Miapaysse/CANSAT-UltraViolet/Multimedia/PROCESS/PCB making.3.jpg

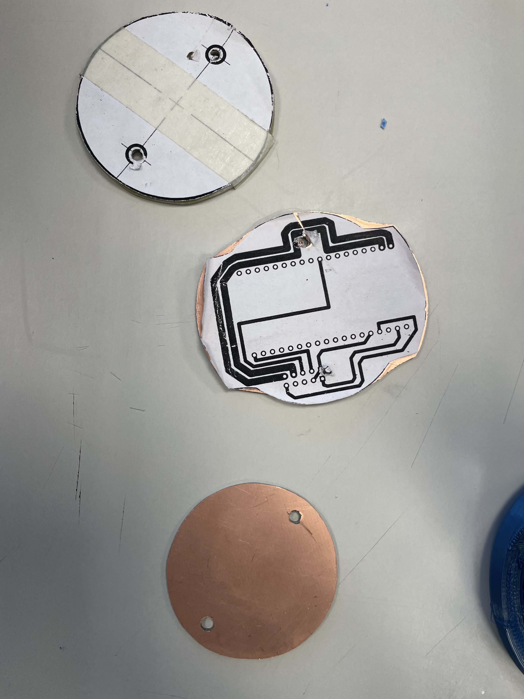
Multimedia/PROCESS/PCB making.3.jpg
