Miapaysse/CANSAT-UltraViolet/Software/Instalación.docx

# Cómo instalar Heltec ESP32 entorno de desarrollo Arduino

https://docs.heltec.org/en/node/esp32/quick_start.html

Instalar desde GitHub

https://github.com/Heltec-Aaron-Lee/WiFi_Kit_series/blob/master/InstallGuide/README_English.md
