Miapaysse/CANSAT-UltraViolet/Investigation/Links.docx

Radiación UV en Bs As

https://www.tutiempo.net/radiacion-solar/buenos-aires.html

DEM (dosis eritematosa mínima) según fototipo

https://www.sciencedirect.com/science/article/pii/S0001731020300843

Relación Índice UV - DEM

http://www.ideam.gov.co/web/tiempo-y-clima/indice-ultravioleta-iuv-

Funcionamiento del ML8511 (sensor UV)

https://learn.sparkfun.com/tutorials/ml8511-uv-sensor-hookup-guide/all
