Miapaysse/CANSAT-UltraViolet/Design/1.JPG

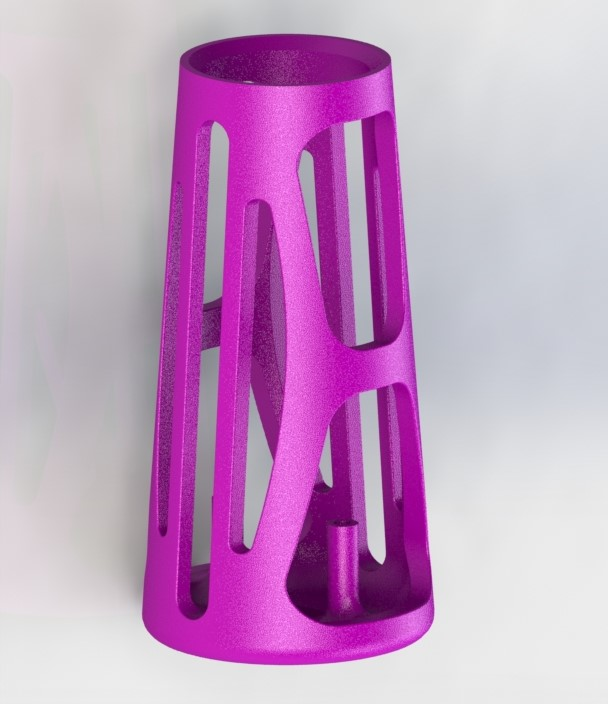
Design/1.JPG
