Miapaysse/CANSAT-UltraViolet/Design/2.JPG

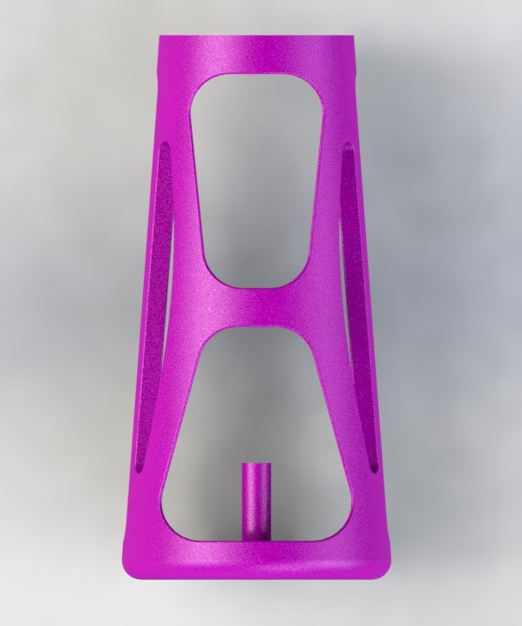
Design/2.JPG
