Miapaysse/CANSAT-UltraViolet/Design/3.JPG

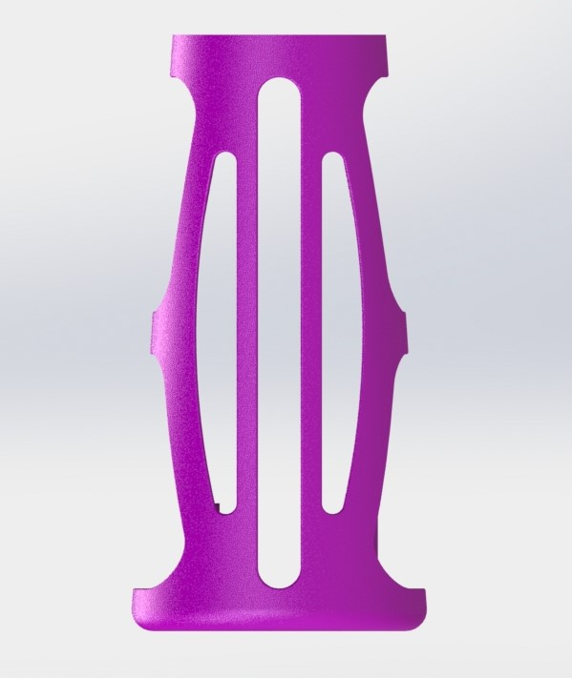
Design/3.JPG
