Miapaysse/CANSAT-UltraViolet/Design/4.JPG

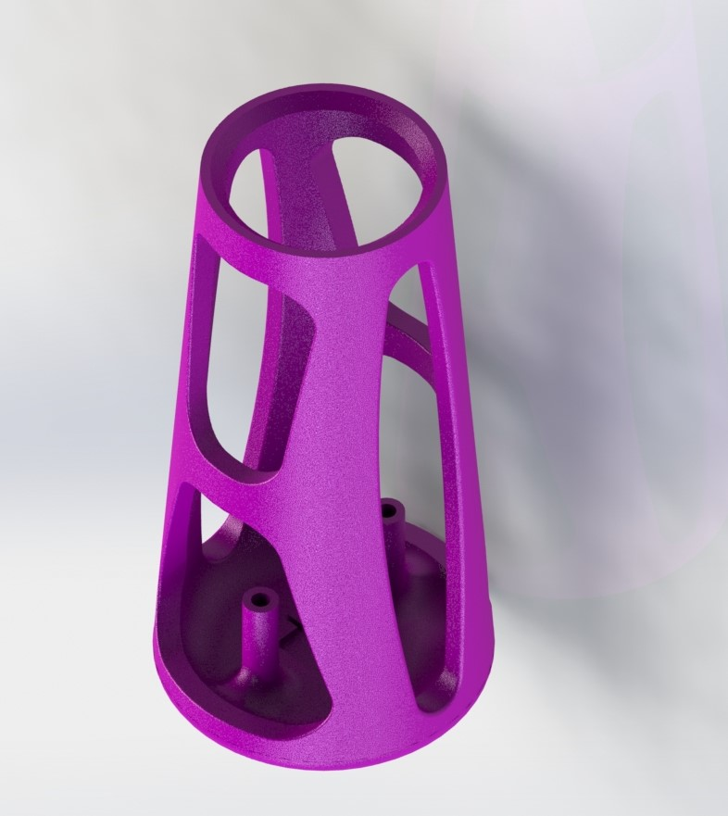
Design/4.JPG
