Miapaysse/CANSAT-UltraViolet/Design/5.JPG

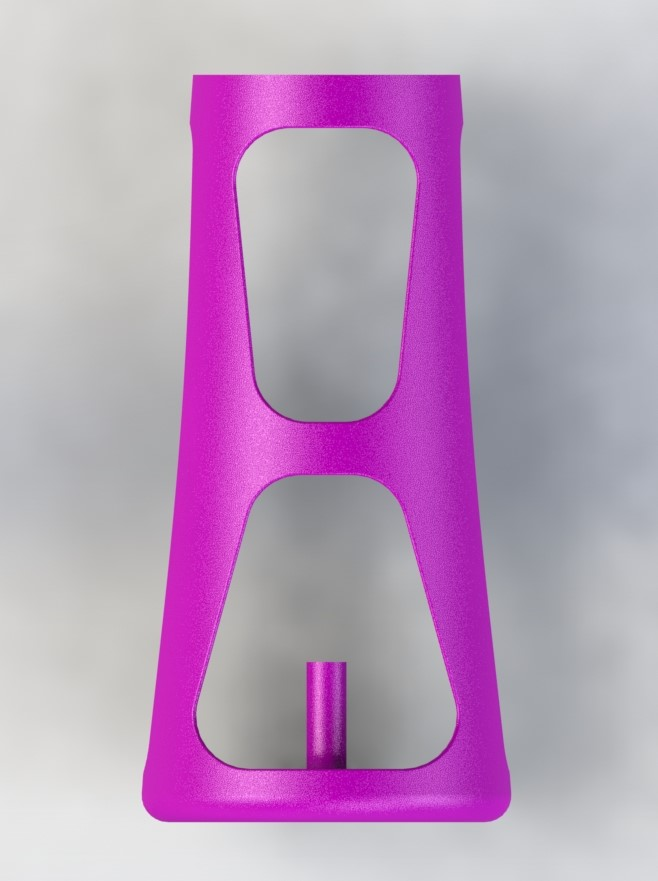
Design/5.JPG
