Miapaysse/CANSAT-UltraViolet/Design/6.JPG

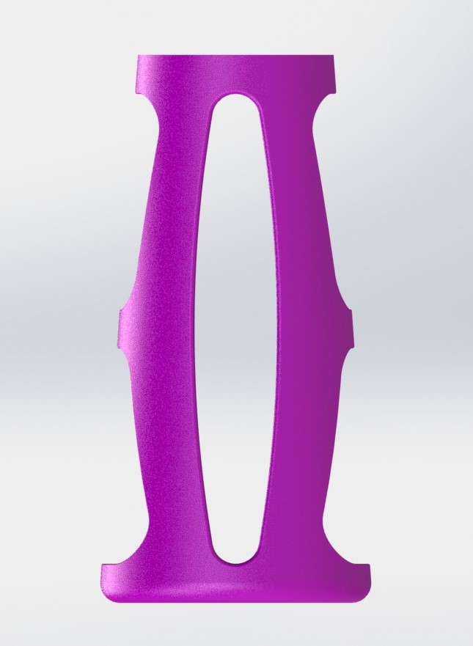
Design/6.JPG
