Miapaysse/CANSAT-UltraViolet/Multimedia/LAUNCH DAY/competitors - launch day (2).jpg

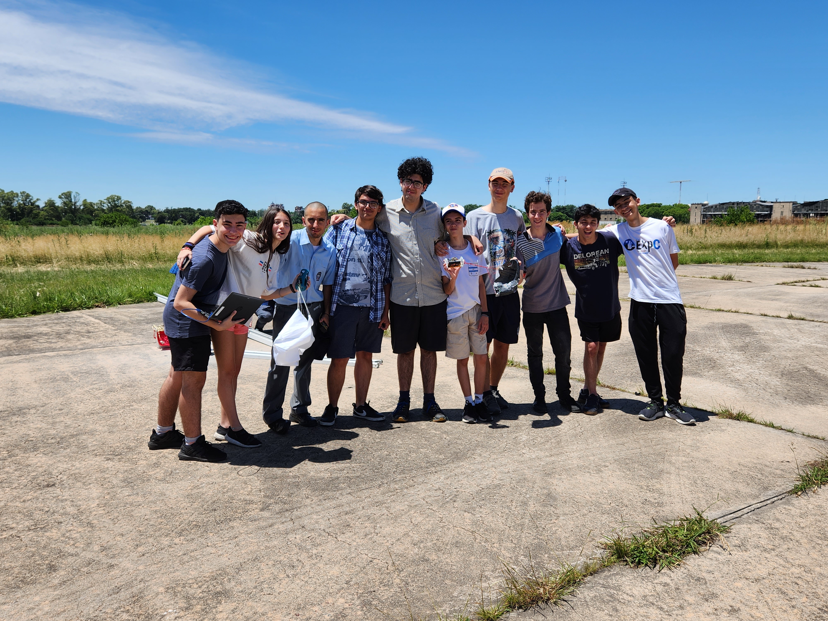
Multimedia/LAUNCH DAY/competitors - launch day (2).jpg
