Miapaysse/CANSAT-UltraViolet/Multimedia/LAUNCH DAY/Competitors - launch day.jpg

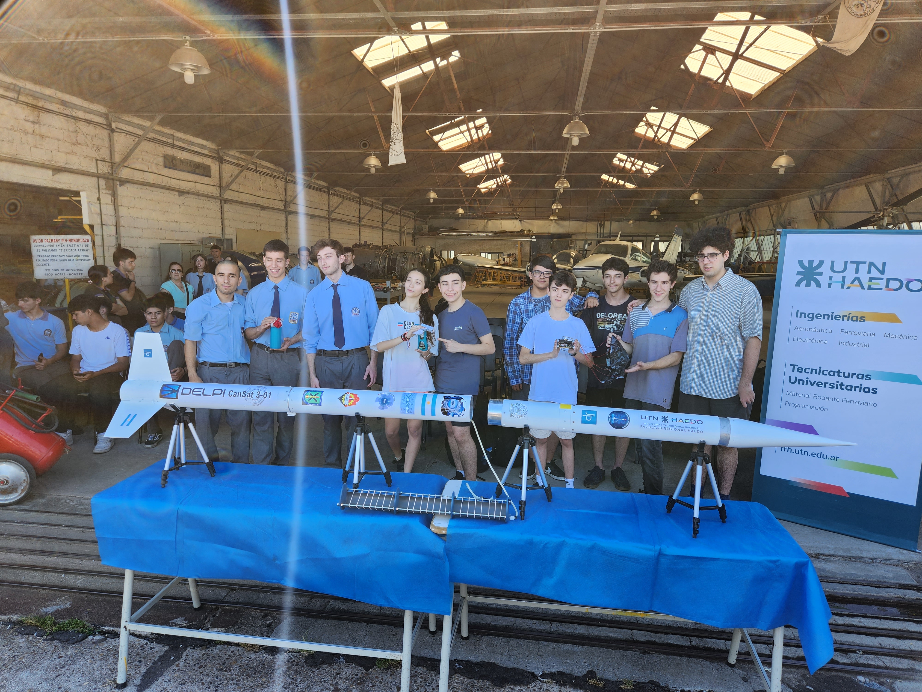
Multimedia/LAUNCH DAY/Competitors - launch day.jpg
