Miapaysse/CANSAT-UltraViolet/Multimedia/LAUNCH DAY/Expulsion (2).jpg

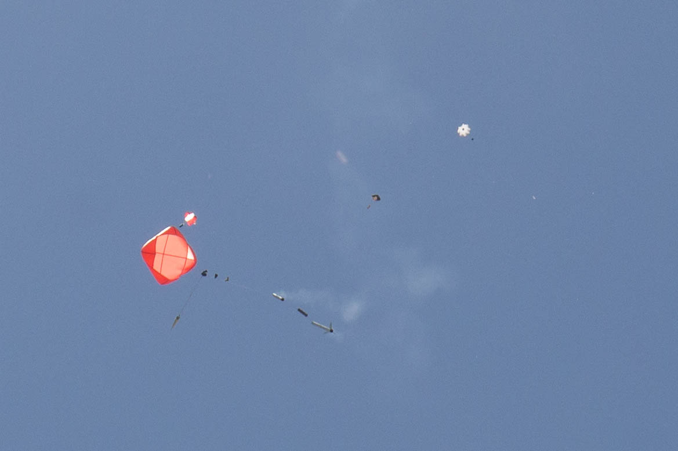
Multimedia/LAUNCH DAY/Expulsion (2).jpg
