Miapaysse/CANSAT-UltraViolet/Multimedia/LAUNCH DAY/Expulsion (3).jpg

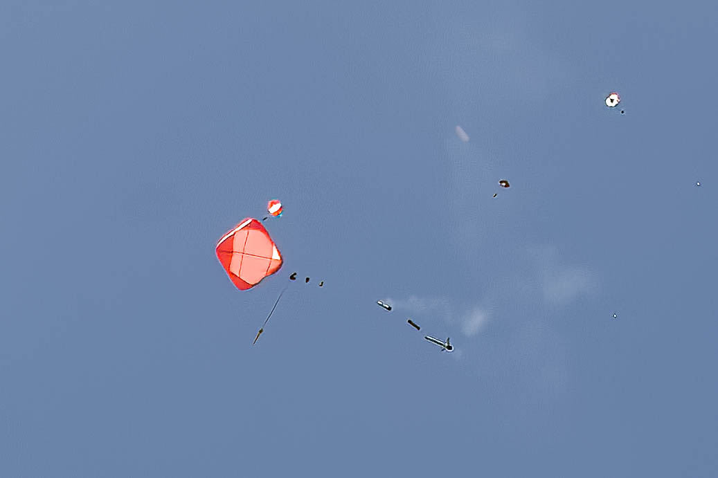
Multimedia/LAUNCH DAY/Expulsion (3).jpg
