Miapaysse/CANSAT-UltraViolet/Multimedia/LAUNCH DAY/Expulsion.jpg

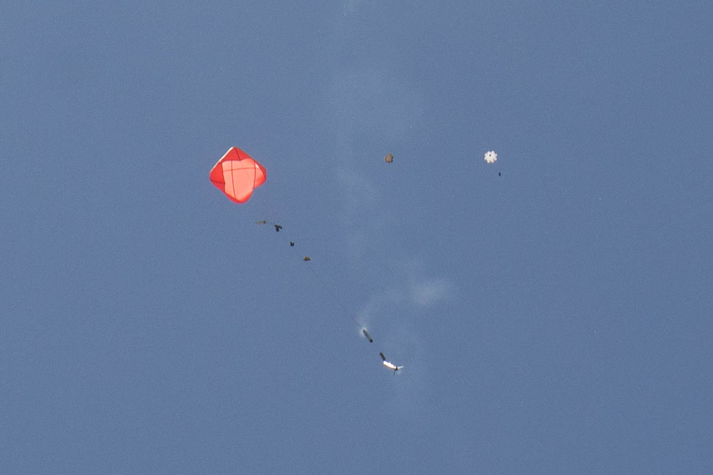
Multimedia/LAUNCH DAY/Expulsion.jpg
