Miapaysse/CANSAT-UltraViolet/Multimedia/LAUNCH DAY/Flying can-sat.jpg

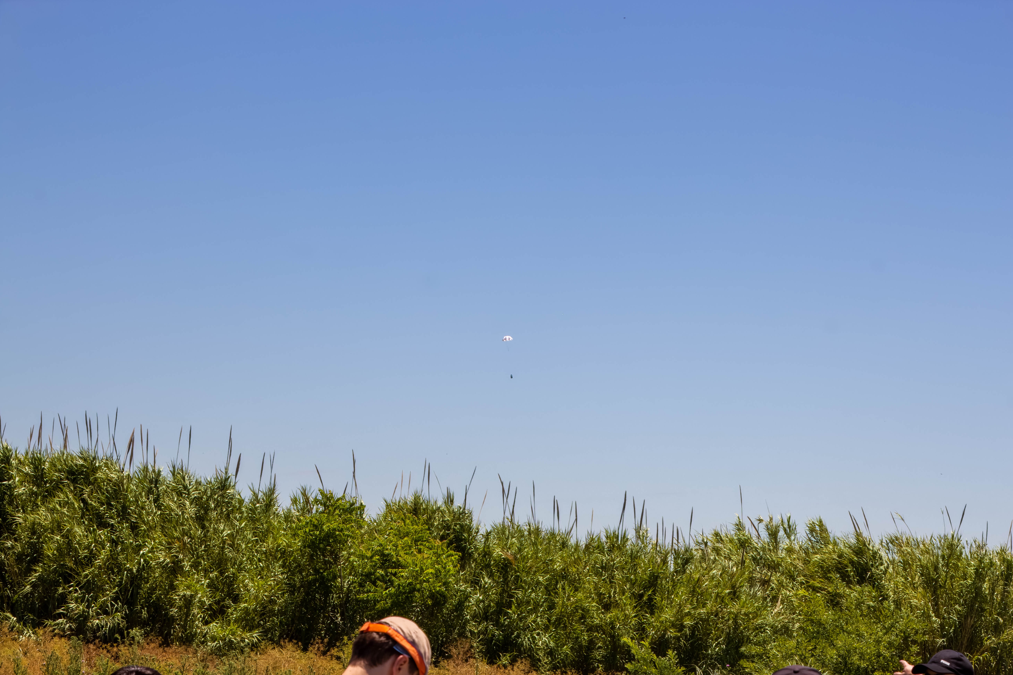
Multimedia/LAUNCH DAY/Flying can-sat.jpg
