Miapaysse/CANSAT-UltraViolet/Multimedia/LAUNCH DAY/Parachute deployment picture.JPEG

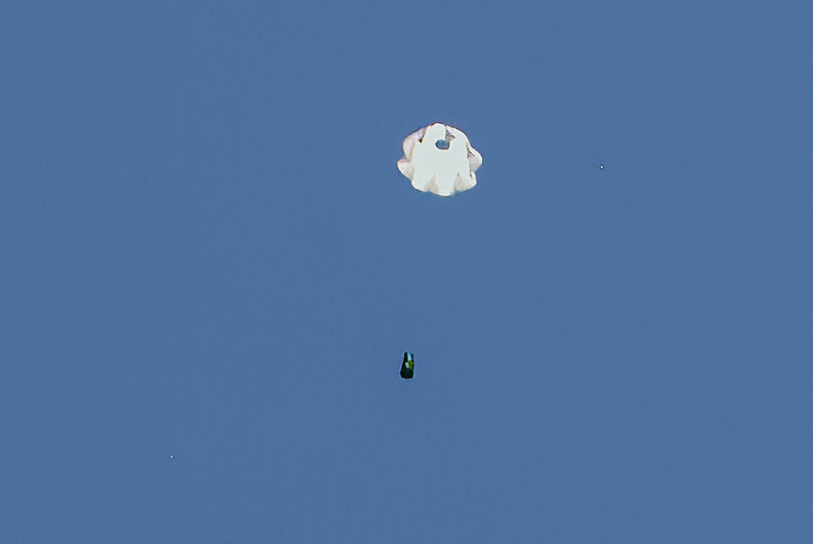
Multimedia/LAUNCH DAY/Parachute deployment picture.JPEG
