Miapaysse/CANSAT-UltraViolet/Multimedia/LAUNCH DAY/rocket (2).jpg

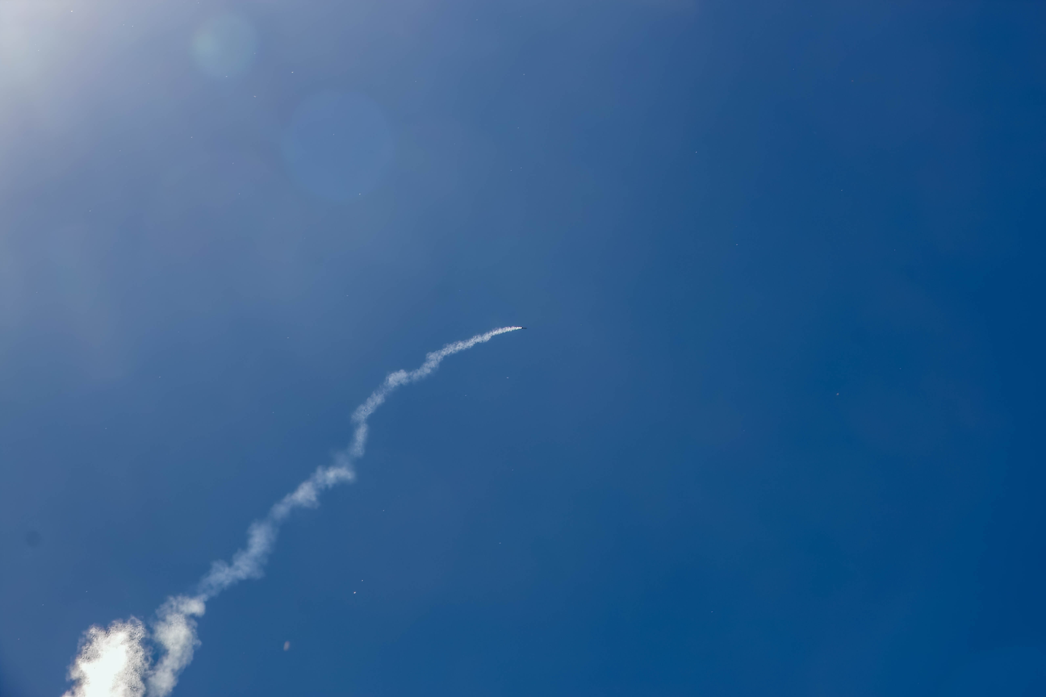
Multimedia/LAUNCH DAY/rocket (2).jpg
