Miapaysse/CANSAT-UltraViolet/Multimedia/LAUNCH DAY/rocket - launch day.jpg

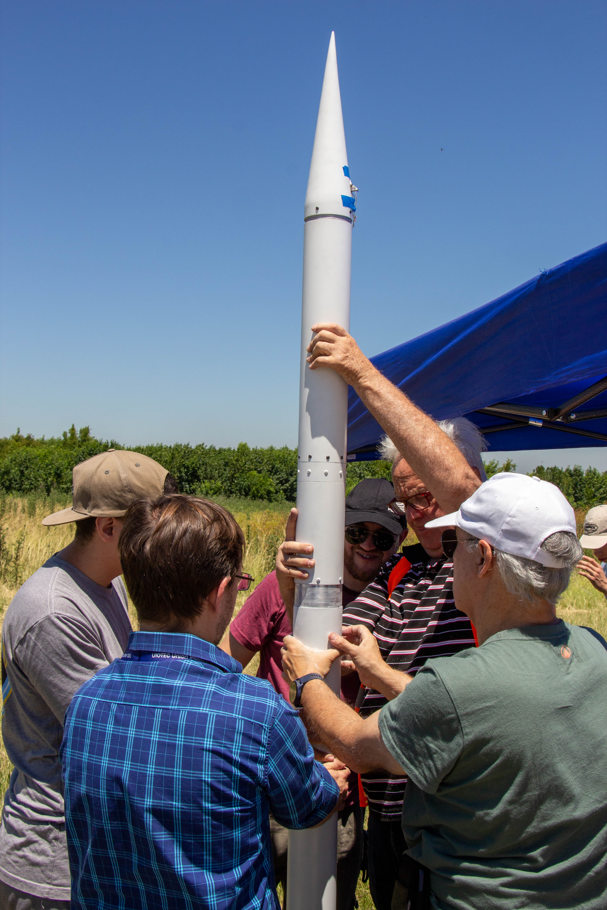
Multimedia/LAUNCH DAY/rocket - launch day.jpg
