Miapaysse/CANSAT-UltraViolet/Multimedia/LAUNCH DAY/rocket.jpg

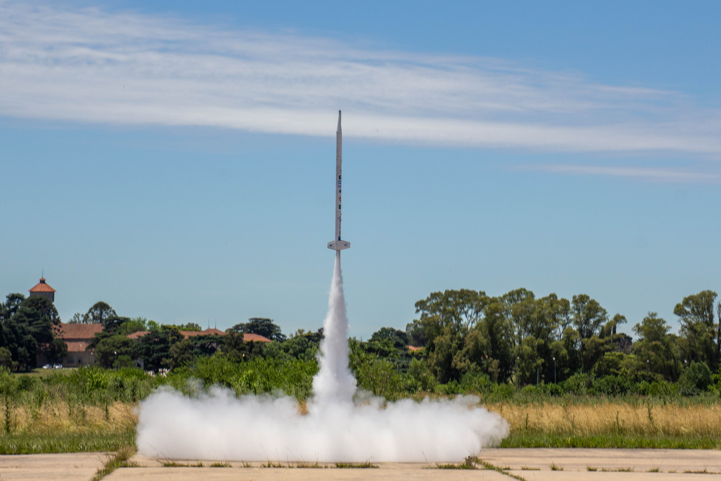
Multimedia/LAUNCH DAY/rocket.jpg
