Miapaysse/CANSAT-UltraViolet/Multimedia/LAUNCH DAY/team - launch day (2).jpg

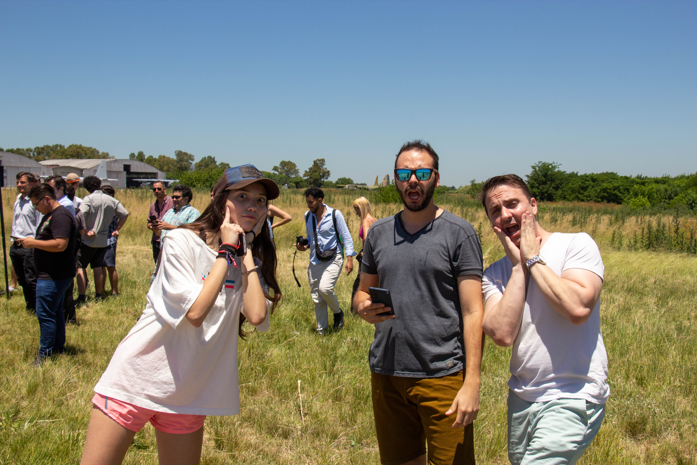
Multimedia/LAUNCH DAY/team - launch day (2).jpg
