Miapaysse/CANSAT-UltraViolet/Multimedia/LAUNCH DAY/Team - launch day (3).jpg

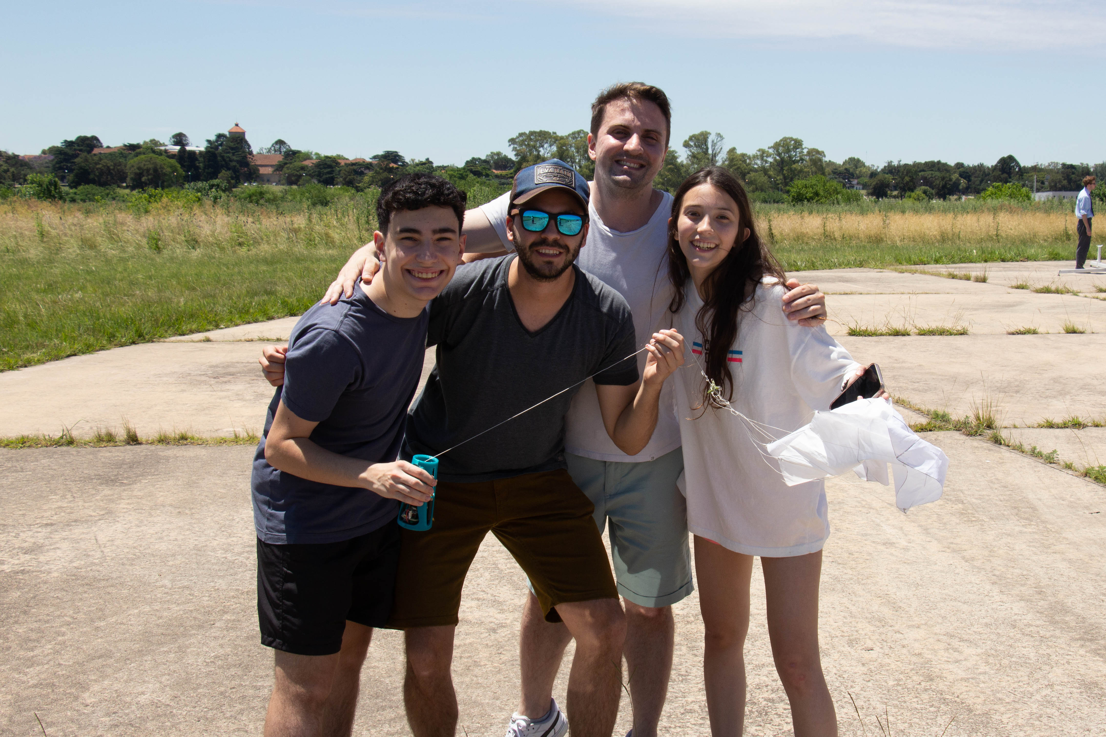
Multimedia/LAUNCH DAY/Team - launch day (3).jpg
