Miapaysse/CANSAT-UltraViolet/Multimedia/LAUNCH DAY/team - launch day.jpg

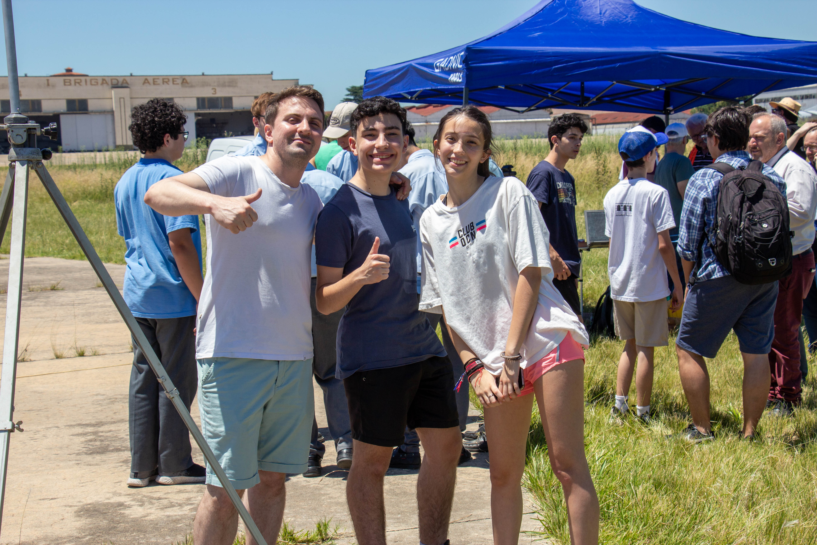
Multimedia/LAUNCH DAY/team - launch day.jpg
