Miapaysse/CANSAT-UltraViolet/Multimedia/LAUNCH DAY/team celebration - launch day.jpg

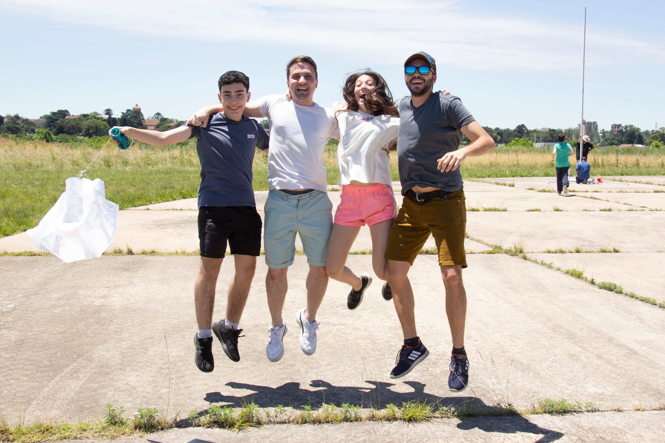
Multimedia/LAUNCH DAY/team celebration - launch day.jpg
