Miapaysse/CANSAT-UltraViolet/Multimedia/LAUNCH DAY/working table 2 - launch day.jpg

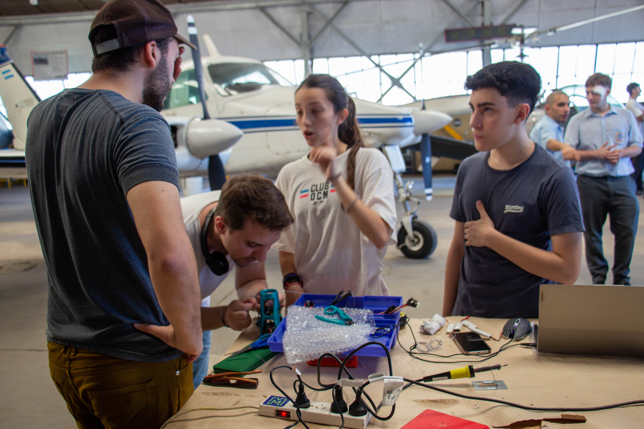
Multimedia/LAUNCH DAY/working table 2 - launch day.jpg
