Miapaysse/CANSAT-UltraViolet/Multimedia/LAUNCH DAY/Working table - launch day.jpg

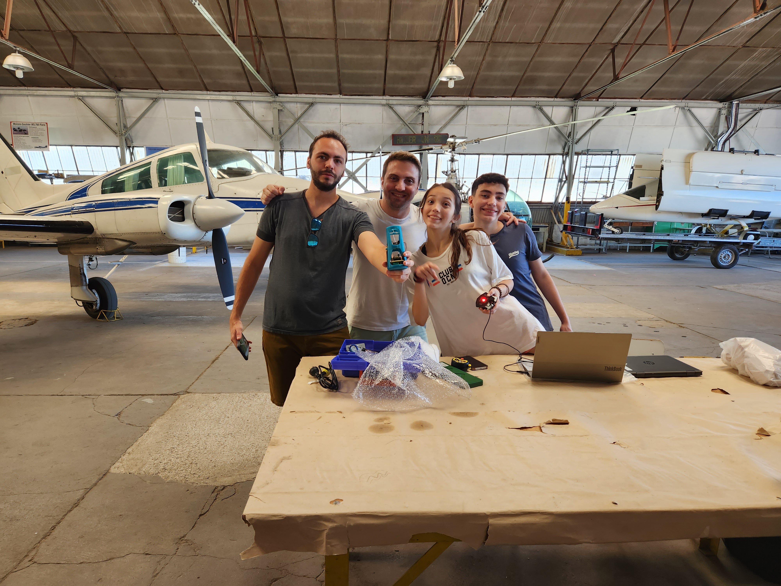
Multimedia/LAUNCH DAY/Working table - launch day.jpg
