Miapaysse/CANSAT-UltraViolet/Multimedia/LAUNCH DAY/WorkingTable pic - only girl.JPG

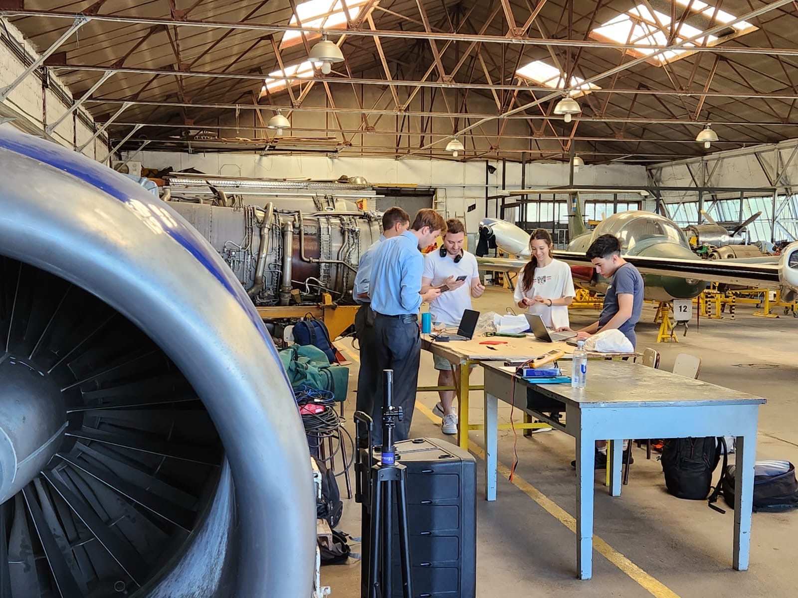
Multimedia/LAUNCH DAY/WorkingTable pic - only girl.JPG
