Miapaysse/CANSAT-UltraViolet/Multimedia/PROCESS/LAST VERSION.jpeg

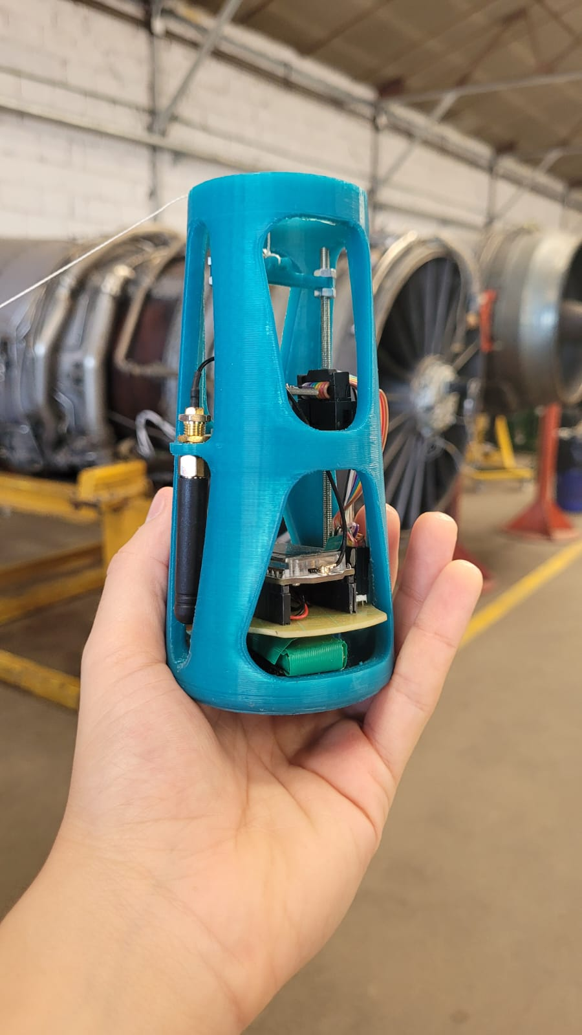
Multimedia/PROCESS/LAST VERSION.jpeg
