Miapaysse/CANSAT-UltraViolet/Multimedia/PROCESS/sketch.jpg

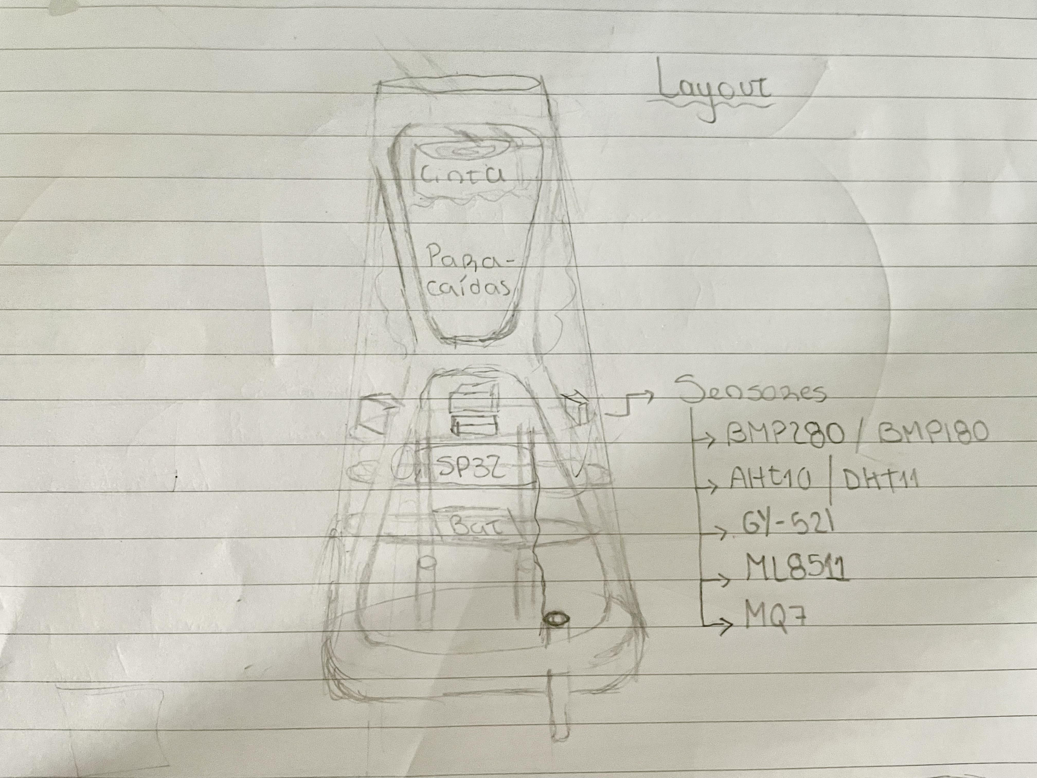
Multimedia/PROCESS/sketch.jpg
