Miapaysse/CANSAT-UltraViolet/Multimedia/PROCESS/V1vsV2.jpg

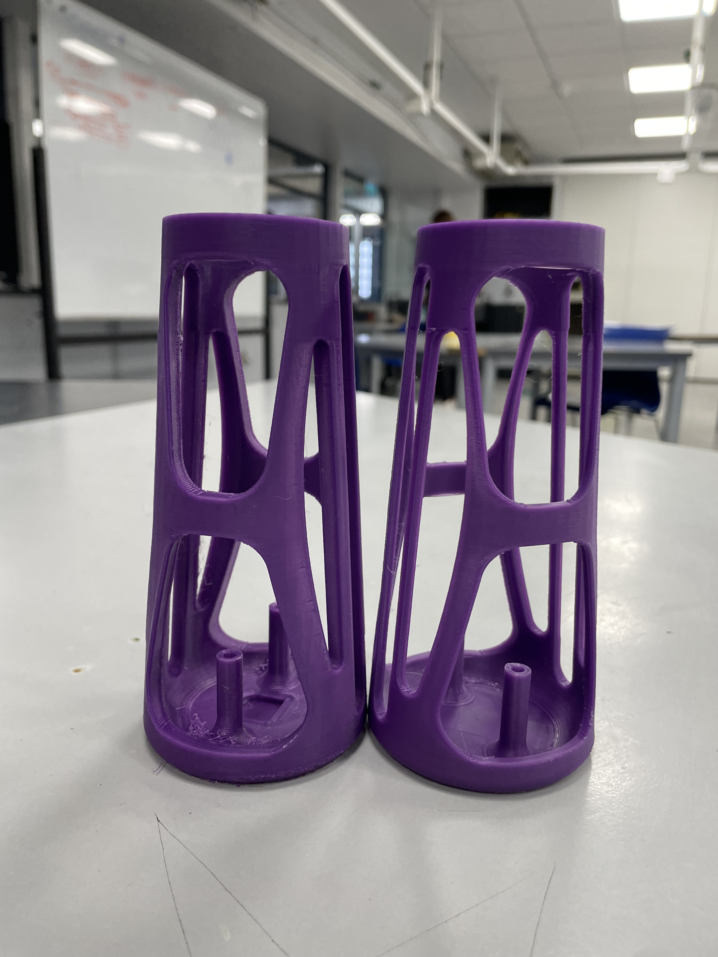
Multimedia/PROCESS/V1vsV2.jpg
