Miapaysse/CANSAT-UltraViolet/Multimedia/PROCESS/V2 prototyping.jpg

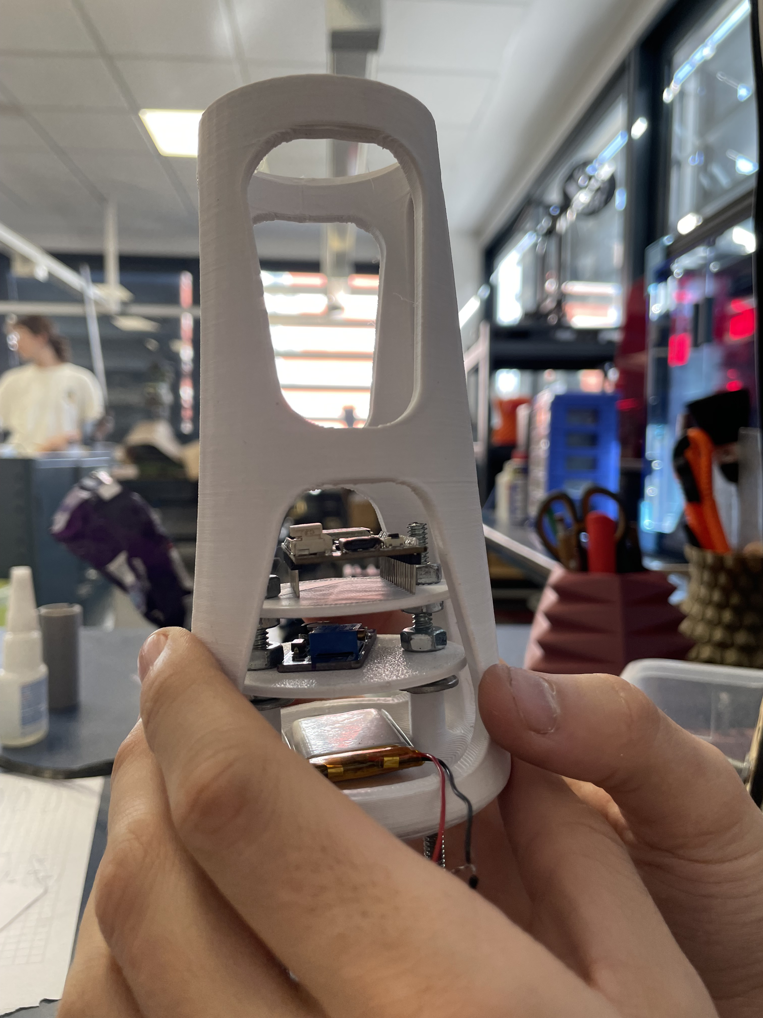
Multimedia/PROCESS/V2 prototyping.jpg
