Miapaysse/CANSAT-UltraViolet/Design/Litio_523450.step

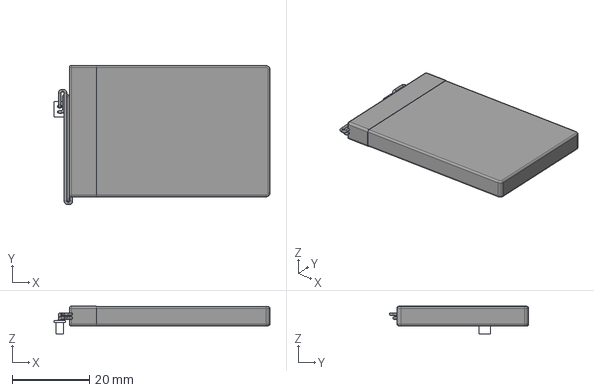
[picture p44: CAD file, 2025-01-06]
Design/Litio_523450.step
56.0 x 36.2 x 7.20 mm
Conector
