Miapaysse/CANSAT-UltraViolet/Hardware/Micro/AUTOCAD 3D 2017.stl

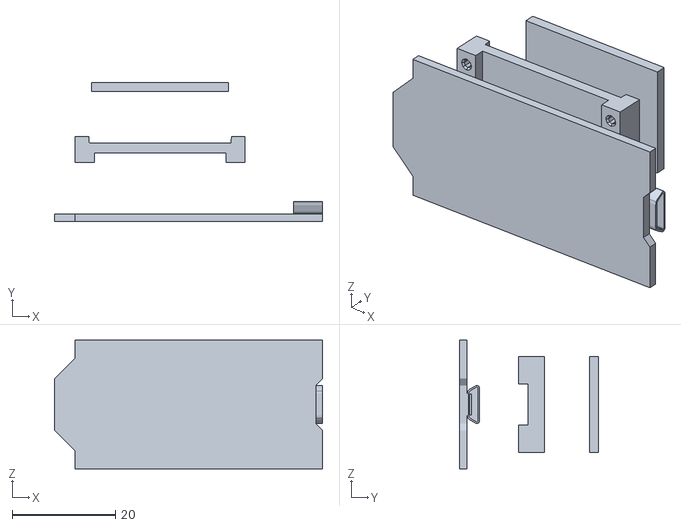
[picture p45: CAD file, 2025-01-06]
Hardware/Micro/AUTOCAD 3D 2017.stl
52.0 x 27.0 x 25.0
