Miapaysse/CANSAT-UltraViolet/Design/MT3608 v3.step

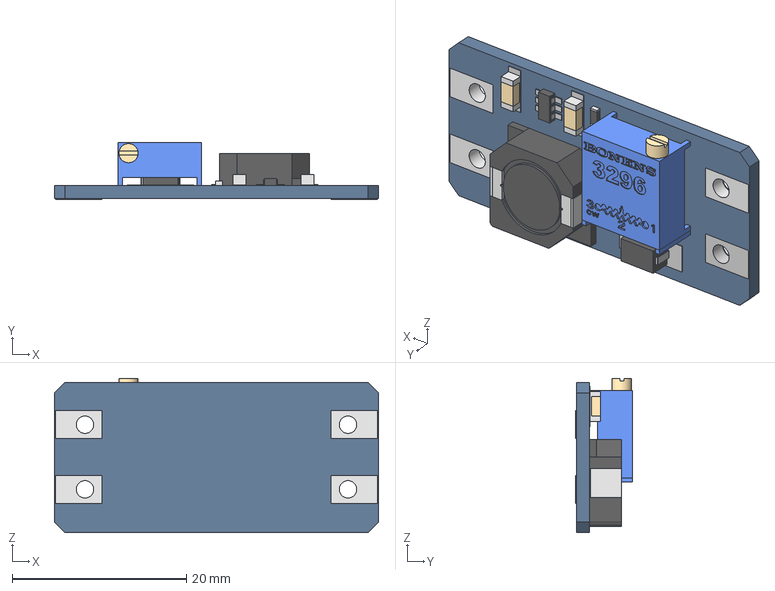
[picture p46: CAD file, 2025-01-06]
Design/MT3608 v3.step
37.2 x 6.49 x 17.7 mm
