Miapaysse/CANSAT-UltraViolet/Design/AHT0 module v3.step

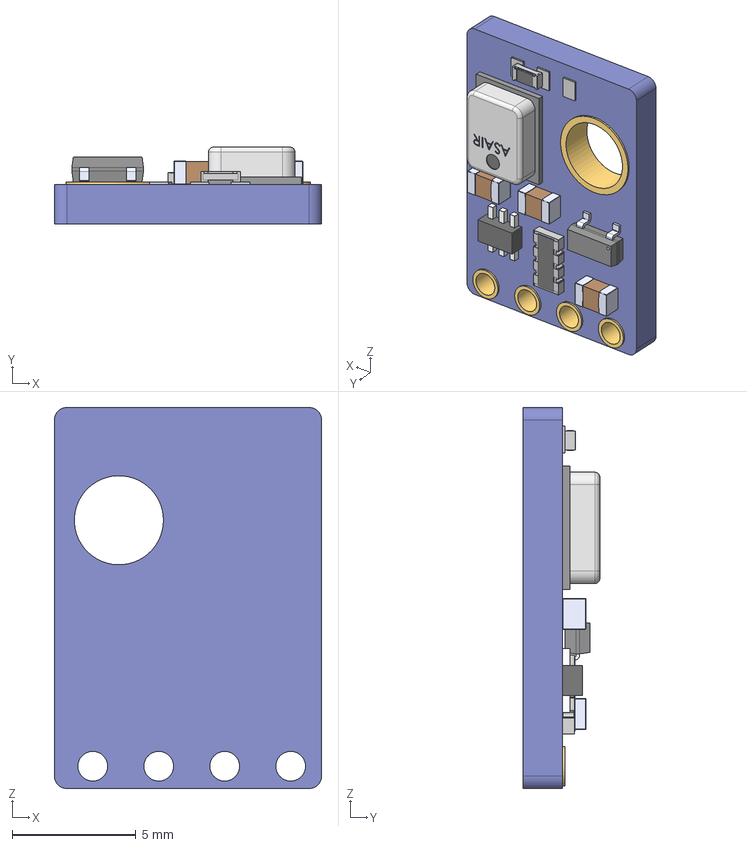
[picture p47: CAD file, 2025-01-06]
Design/AHT0 module v3.step
10.8 x 3.10 x 15.4 mm
AHT10
LD051A121KAB2A x 3
cay16-103j4lf
BSS138
