Miapaysse/CANSAT-UltraViolet/Design/Pieza2.SLDPRT

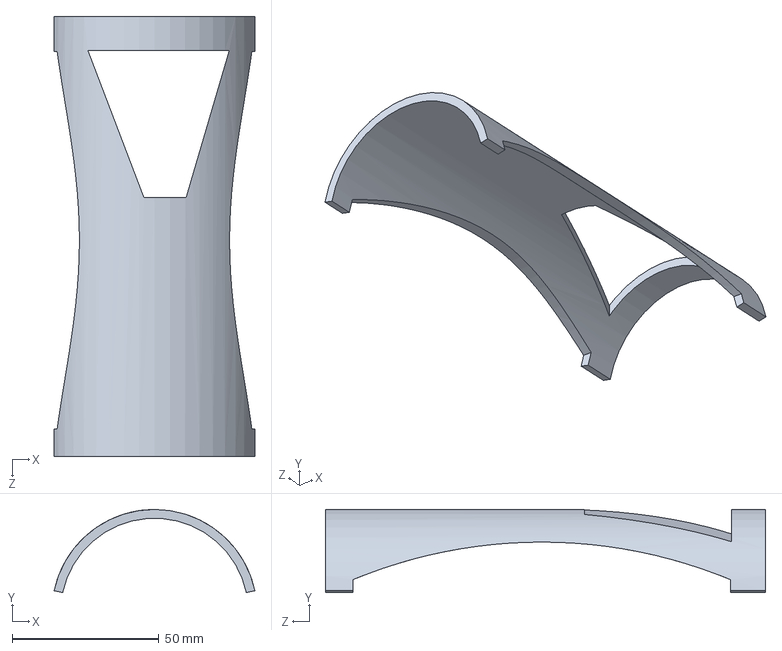
[picture p48: CAD file, 2025-01-06]
Design/Pieza2.SLDPRT
68.5 x 28.3 x 150.0 mm
