Miapaysse/CANSAT-UltraViolet/Design/Plaqueta 2.SLDPRT

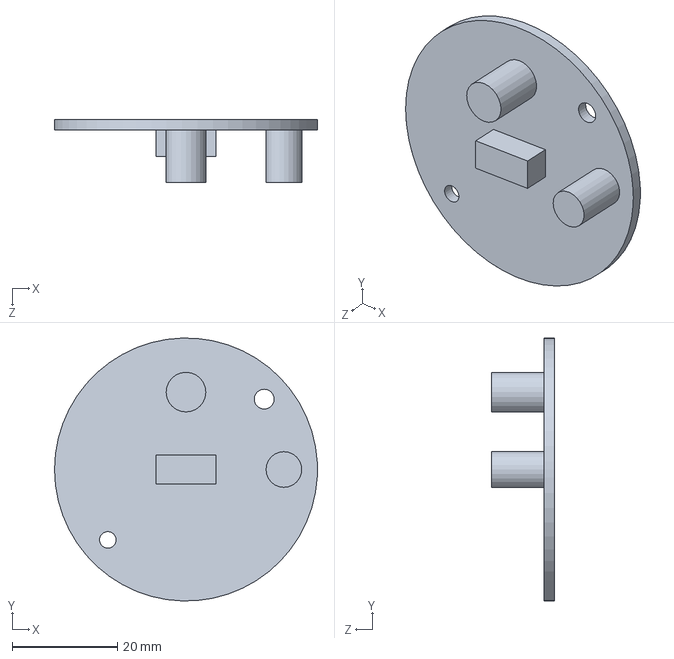
[picture p49: CAD file, 2025-01-06]
Design/Plaqueta 2.SLDPRT
50.0 x 50.0 x 12.0 mm
