Miapaysse/CANSAT-UltraViolet/Design/Prototipo n2 - CANSAT equipo 1.SLDPRT

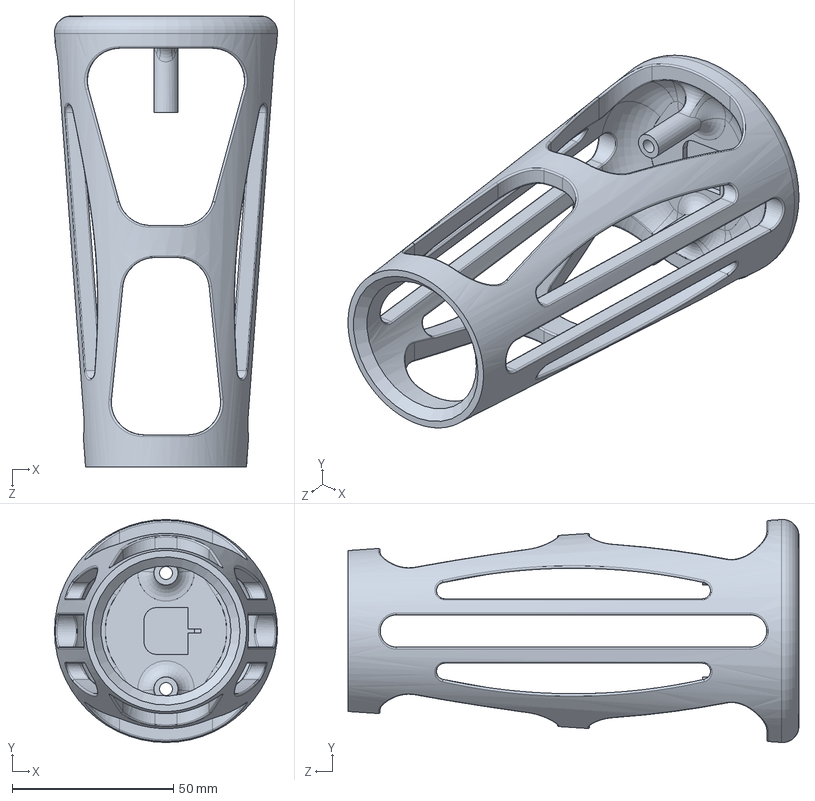
[picture p51: CAD file, 2025-01-06]
Design/Prototipo n2 - CANSAT equipo 1.SLDPRT
69.2 x 69.2 x 140.0 mm
