Miapaysse/CANSAT-UltraViolet/Design/Varilla.SLDPRT

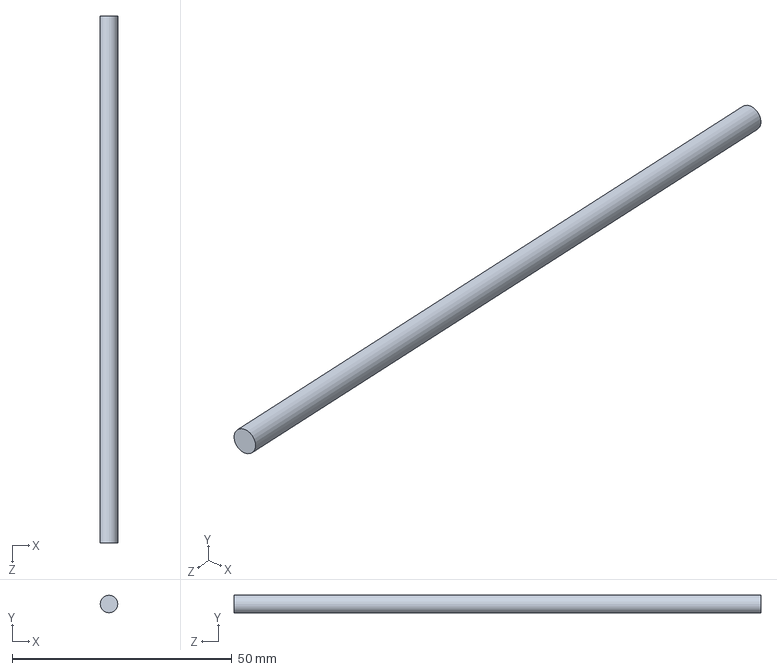
[picture p52: CAD file, 2025-01-06]
Design/Varilla.SLDPRT
4.00 x 4.00 x 120.0 mm
