Miapaysse/CANSAT-UltraViolet/Design/MQ 7 Sensor.SLDPRT

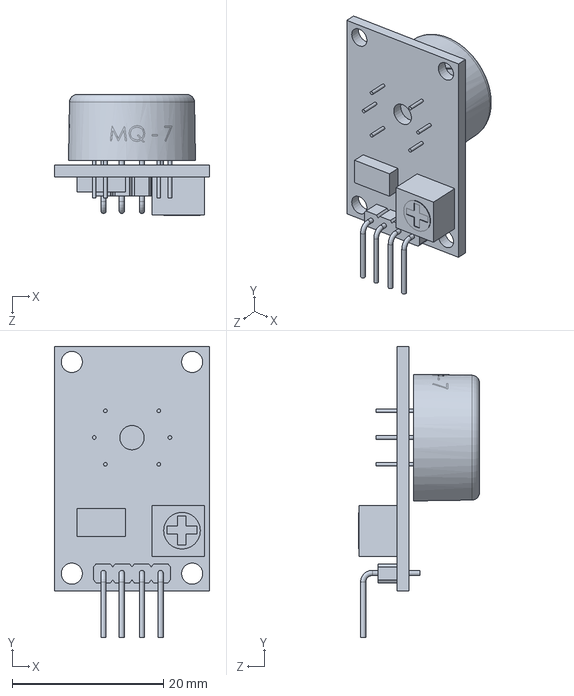
[picture p53: CAD file, 2025-01-06]
Design/MQ 7 Sensor.SLDPRT
20.5 x 38.5 x 16.0 mm
