Miapaysse/CANSAT-UltraViolet/Design/ITG-MPU.STEP

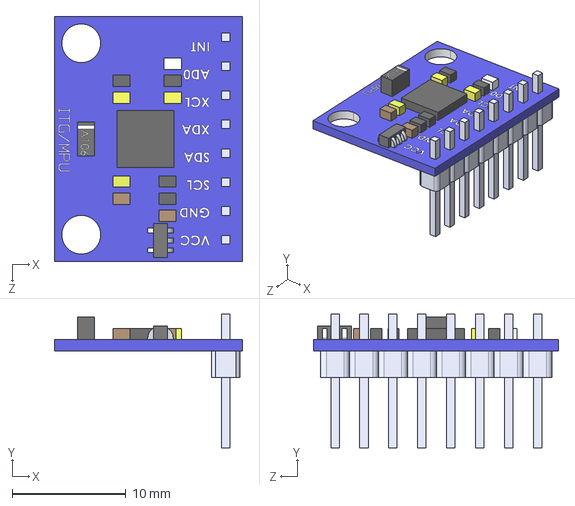
[picture p54: CAD file, 2025-01-06]
Design/ITG-MPU.STEP
16.5 x 11.8 x 21.5 mm
8 Header-Pin
Placa_Base
