Miapaysse/CANSAT-UltraViolet/Design/plaqueta.SLDPRT

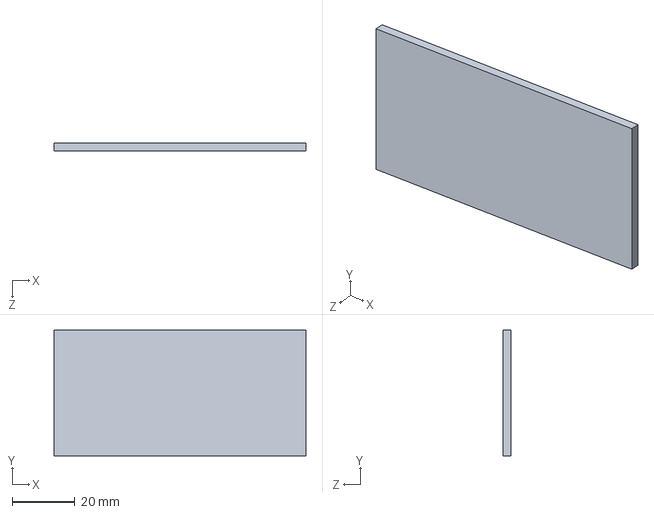
[picture p55: CAD file, 2025-01-06]
Design/plaqueta.SLDPRT
80.0 x 40.0 x 2.50 mm
