Miapaysse/CANSAT-UltraViolet/Design/Plaqueta 1 bateria.SLDPRT

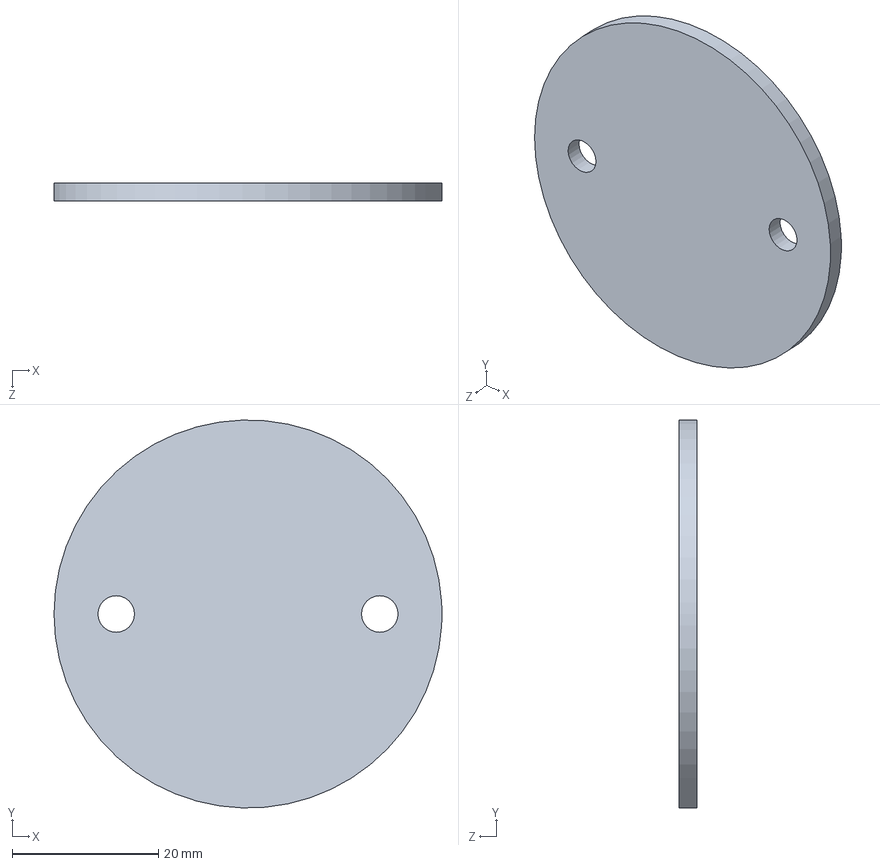
[picture p56: CAD file, 2025-01-06]
Design/Plaqueta 1 bateria.SLDPRT
53.0 x 53.0 x 2.50 mm
