Miapaysse/CANSAT-UltraViolet/Design/Prototipo CANSAT equipo 1.SLDPRT

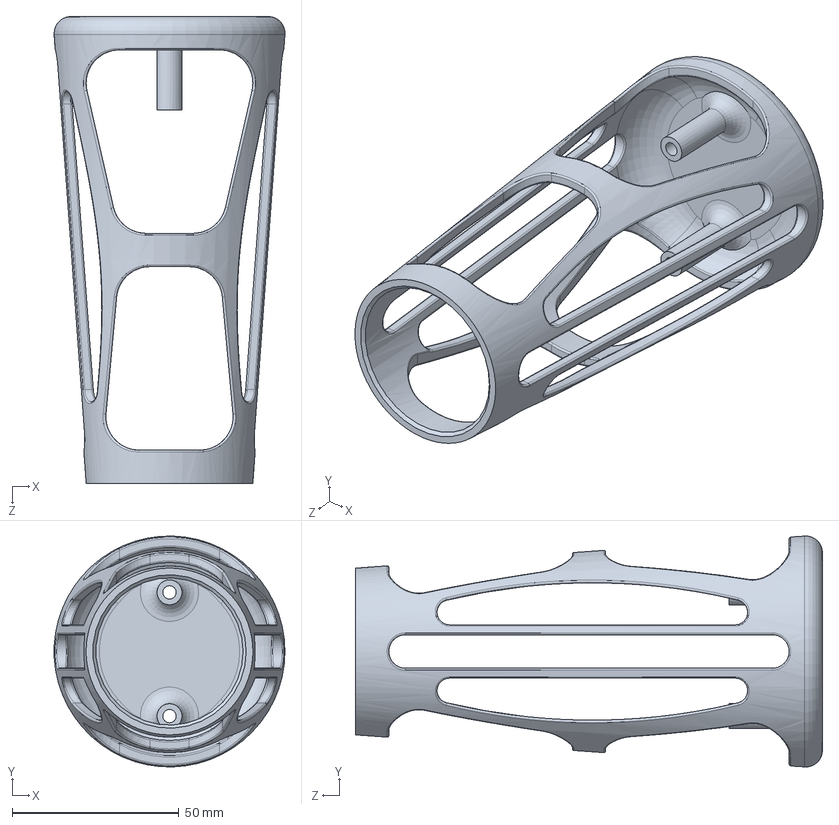
[picture p57: CAD file, 2025-01-06]
Design/Prototipo CANSAT equipo 1.SLDPRT
69.2 x 69.2 x 140.0 mm
