Miapaysse/CANSAT-UltraViolet/Design/bmp.stp

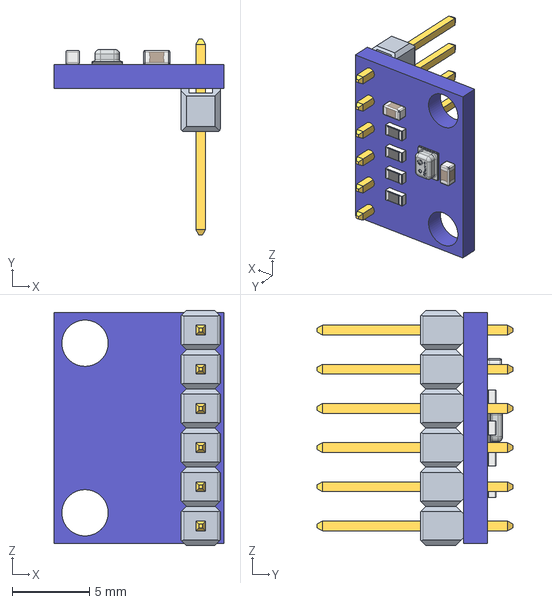
[picture p58: CAD file, 2025-01-06]
Design/bmp.stp
11.0 x 12.7 x 15.2 mm
