Miapaysse/CANSAT-UltraViolet/Design/SparkFun_BMP180.step

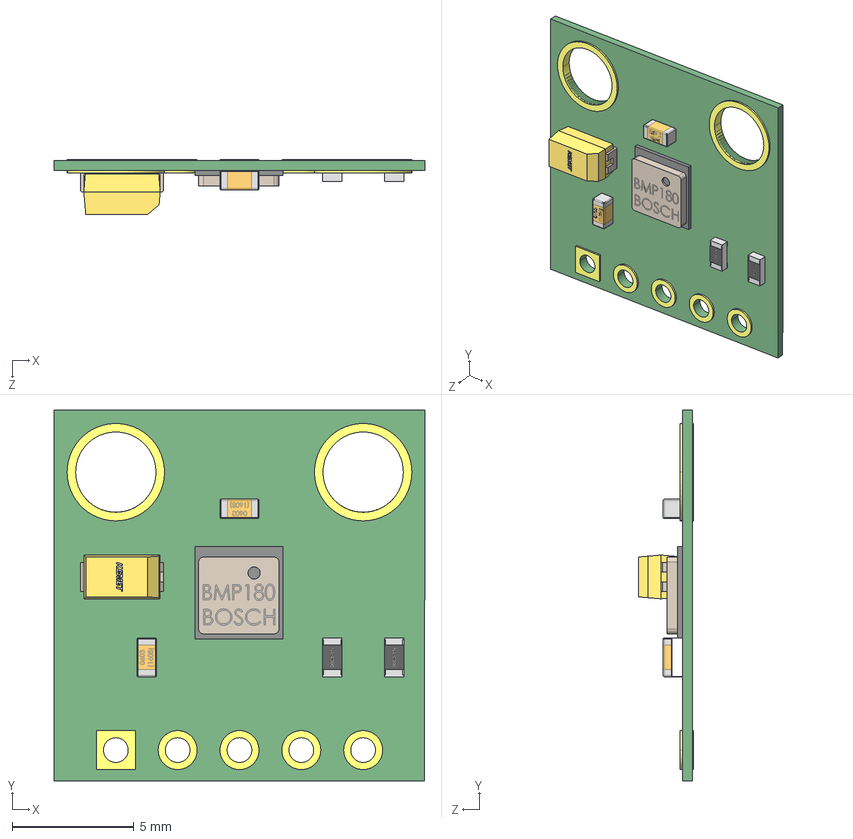
[picture p59: CAD file, 2025-01-06]
Design/SparkFun_BMP180.step
15.2 x 15.2 x 2.26 mm
