Miapaysse/CANSAT-UltraViolet/Design/Plaqueta 2 sp32 lora.SLDPRT

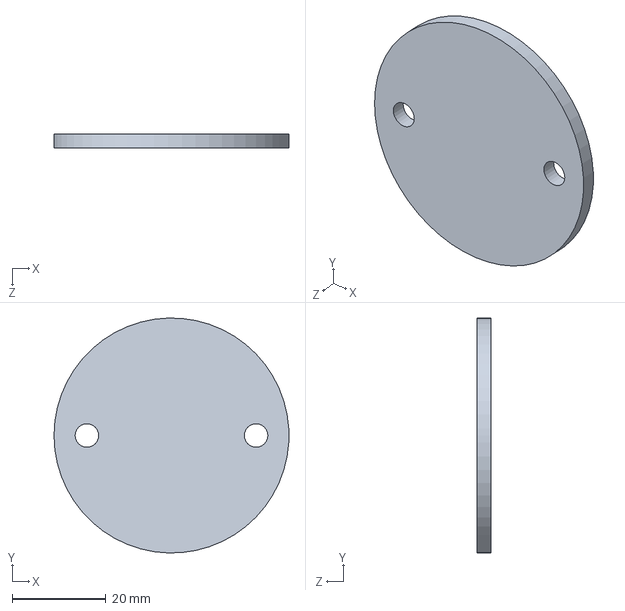
[picture p60: CAD file, 2025-01-06]
Design/Plaqueta 2 sp32 lora.SLDPRT
50.0 x 50.0 x 3.00 mm
