Miapaysse/CANSAT-UltraViolet/Design/Lipo Charger - With Load Protection.stp

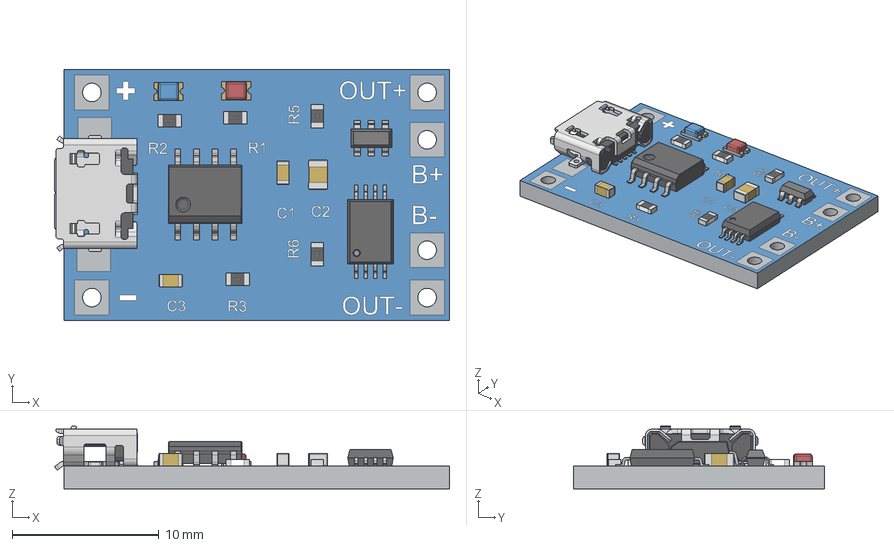
[picture p61: CAD file, 2025-01-06]
Design/Lipo Charger - With Load Protection.stp
26.9 x 17.1 x 4.28 mm
bOARD
0603 Capacitor x 2
0603 Resistor x 5
0805 Capacitor
SOIC-8-150
LED - 0805 - Blue
LED - 0805 - Red
USB - Micro
tsop8
sot-23-6-2
