Miapaysse/CANSAT-UltraViolet/(list of files, cad)

Other CAD files:
Hardware/Micro/Solid Works 2014.dwg
Design/18650.stp
Design/18650BatteryCase v6.step
Design/Prototipo n2 - CANSAT equipo 1.STL
