Miapaysse/CANSAT-UltraViolet/Multimedia/PROCESS/PCB making.jpg

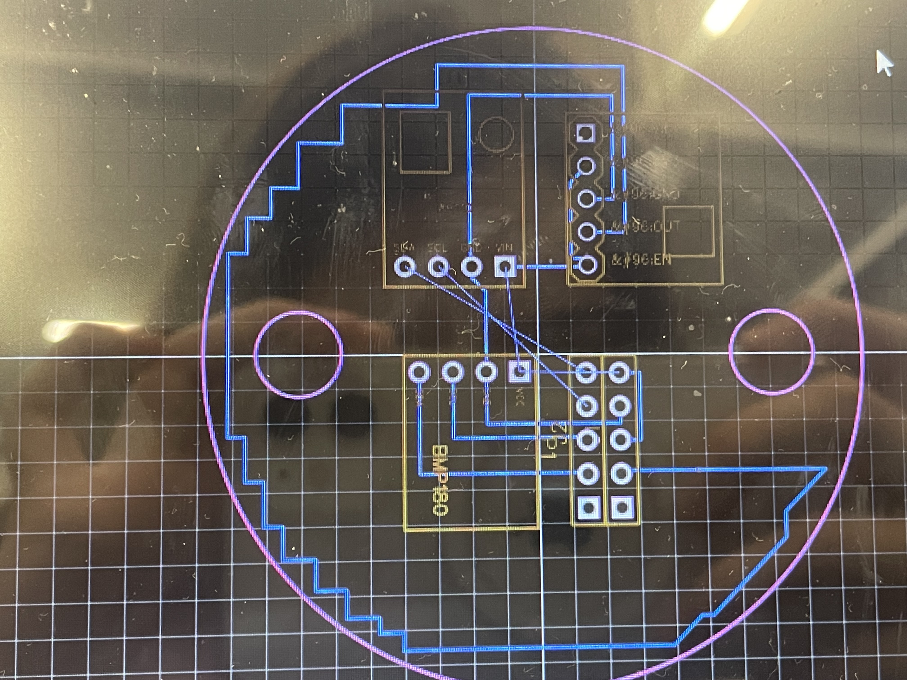
Multimedia/PROCESS/PCB making.jpg
