Miapaysse/CANSAT-UltraViolet/Hardware/Micro/esquemático-chip-SX1278.PDF

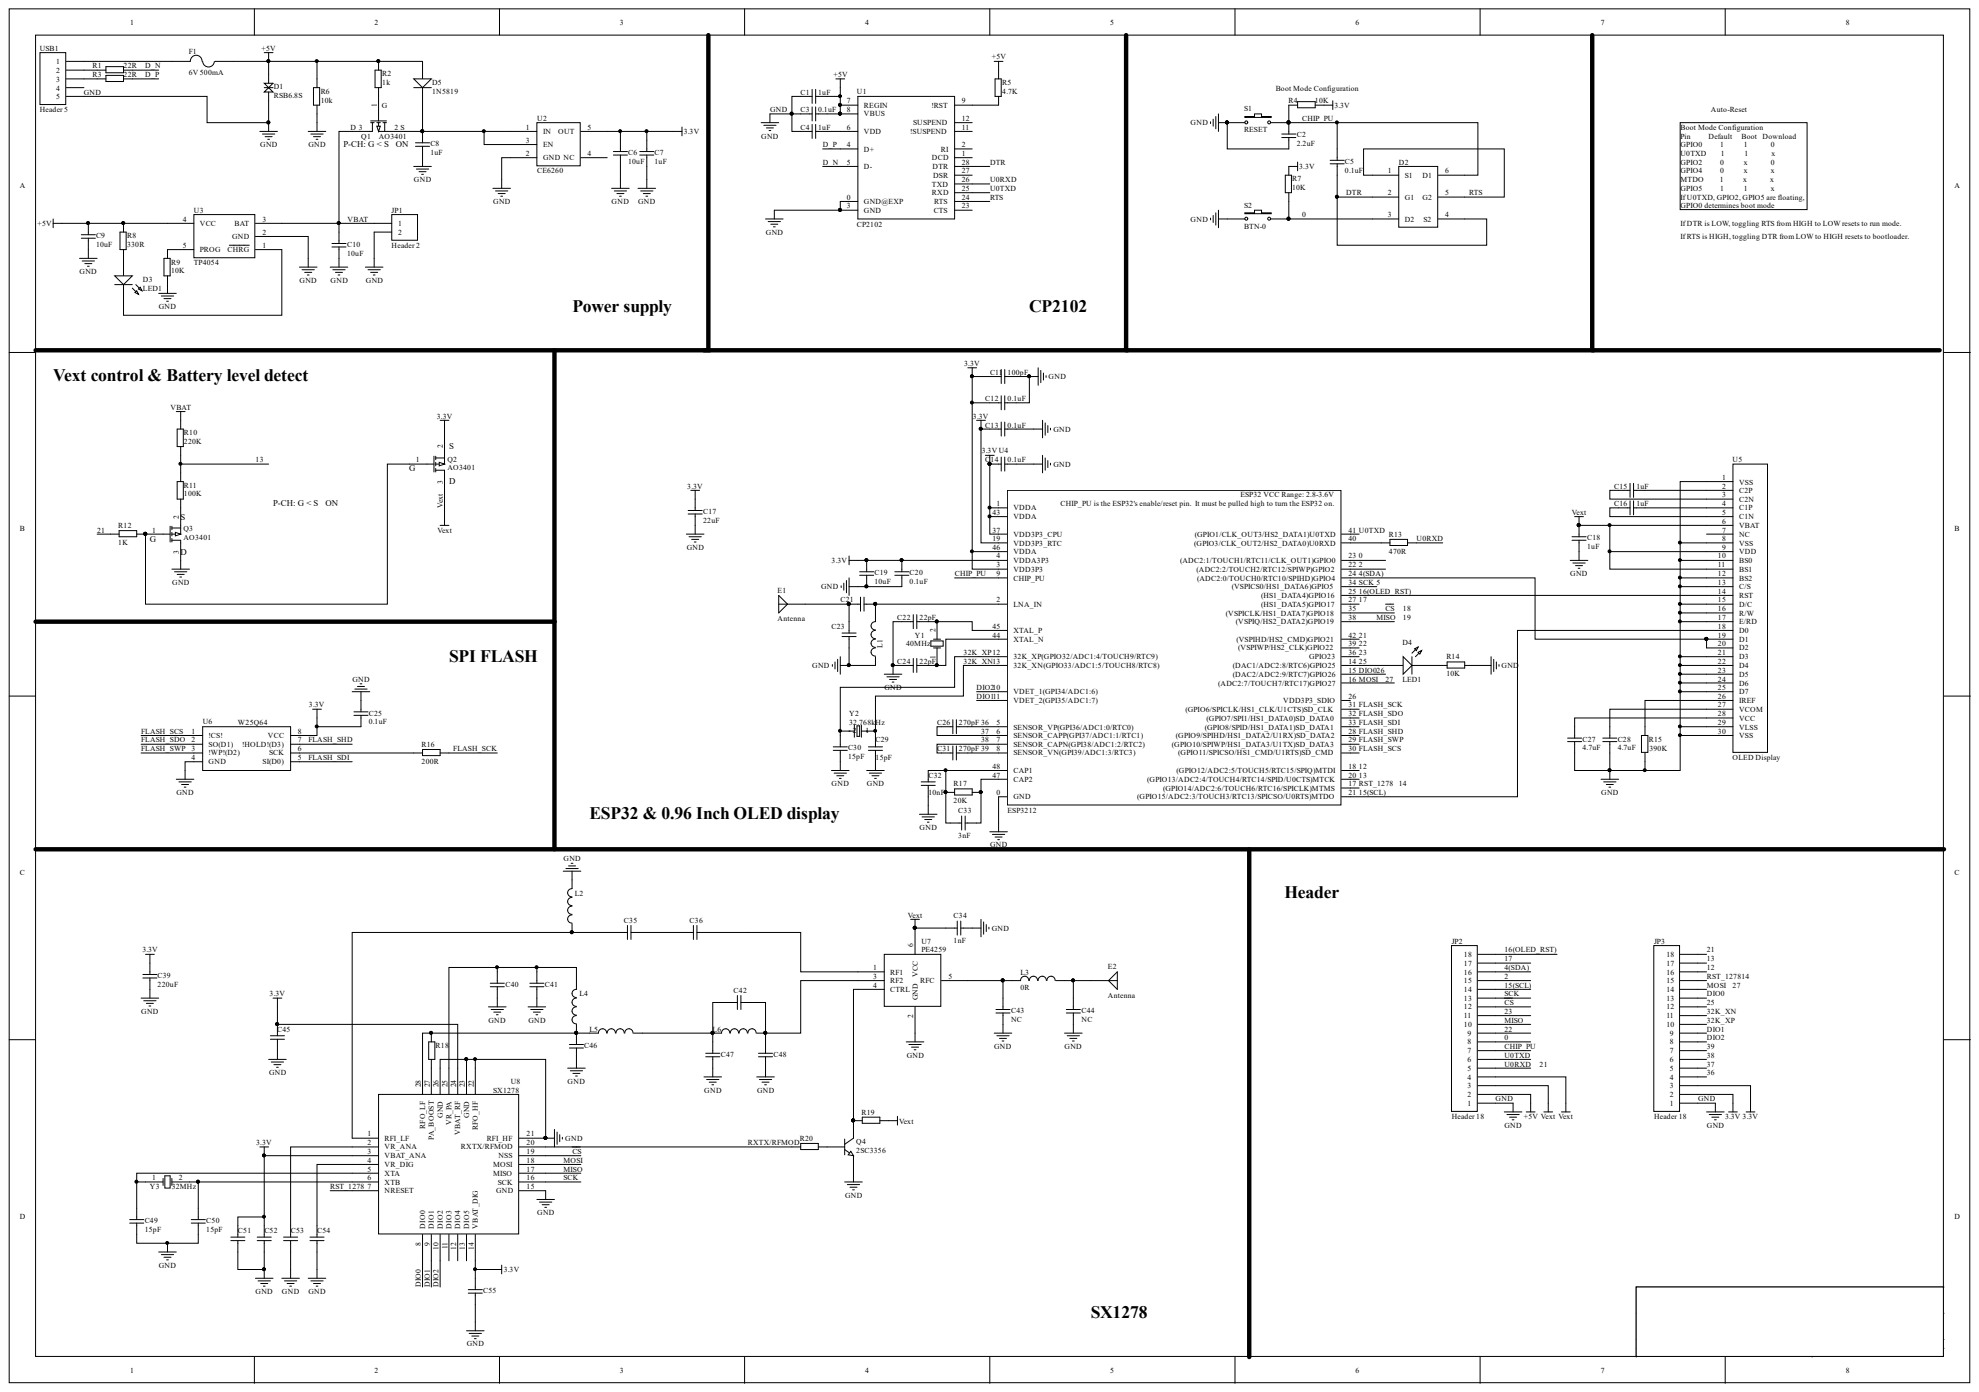
[picture p65: page 1]

If DTR is LOW, toggling RTS from HIGH to LOW resets to run mode.
If RTS is HIGH, toggling DTR from LOW to HIGH resets to bootloader.

Vext control & Battery level detect

CHIP_PU is the ESP32's enable/reset pin. It must be pulled high to turn the ESP32 on.

C1N 5
VBAT 6
NC 7

VCOM 27
VCC 28
VLSS 29

C45 | | GND

U8 SX1278 | GND

GND

VR_ANA 2
VBAT_ANA 3 | CS
VR_DIG 4 | MOSI
XTA 5 | MISO

1 | 2 | | | | | XTB 6 | SCK

RST_1278 | | NRESET 7

Size A2 | Number | Revision

Date: 2018/11/15 | Sheet of
File: C:\Users\Aaron.Lee\Desktop\导出原理图D.SrcahwDnoBcy:
