Miapaysse/CANSAT-UltraViolet/(commit log)

2025-01-06 Upload Sofi´s folder
    [AUTOCAD 3D 2017.stl, Solid Works 2014.dwg]
2025-01-06 Upload design, PDD & results
    [18650.stp, 18650BatteryCase v6.step, AHT0 module v3.step, DATA FROM LAUNCH.xlsx, ITG-MPU.STEP, Lipo Charger - With Load Protection.stp, Litio_523450.step, MQ 7 Sensor.SLDPRT]
