Miapaysse/CANSAT-UltraViolet/Multimedia/PROCESS/V1.2 & CAN.jpg

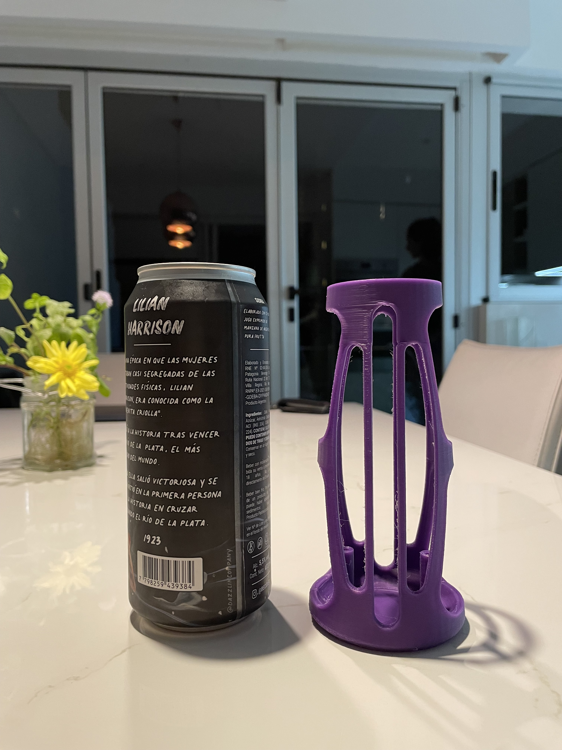
Multimedia/PROCESS/V1.2 & CAN.jpg
