Miapaysse/CANSAT-UltraViolet/Multimedia/PROCESS/Schematics making.jpg

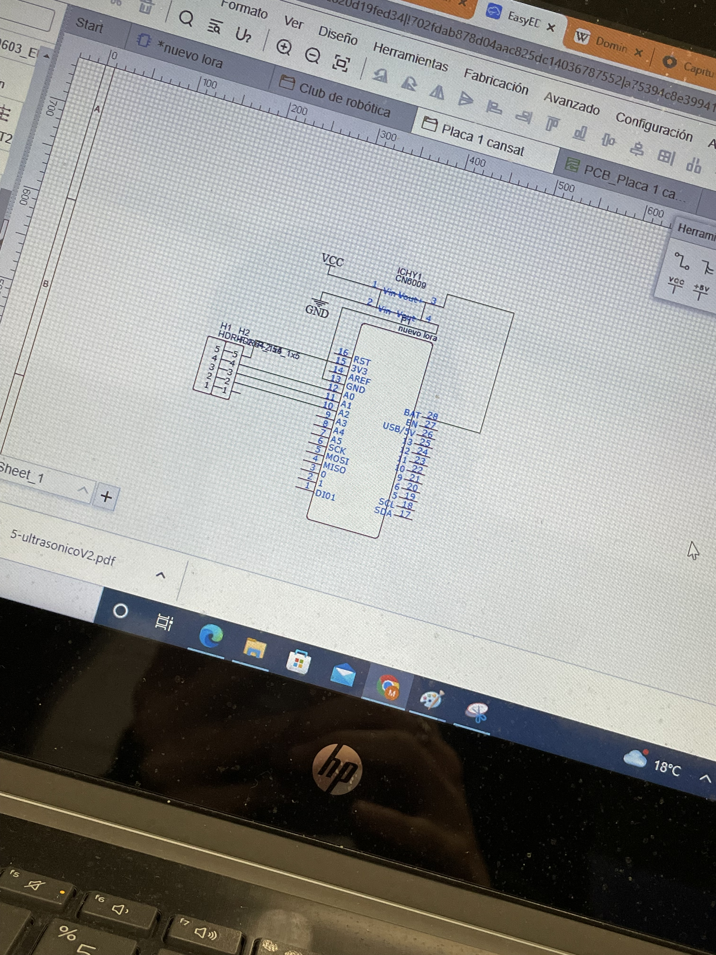
Multimedia/PROCESS/Schematics making.jpg
