Miapaysse/CANSAT-UltraViolet/Multimedia/PROCESS/V2 making.jpg

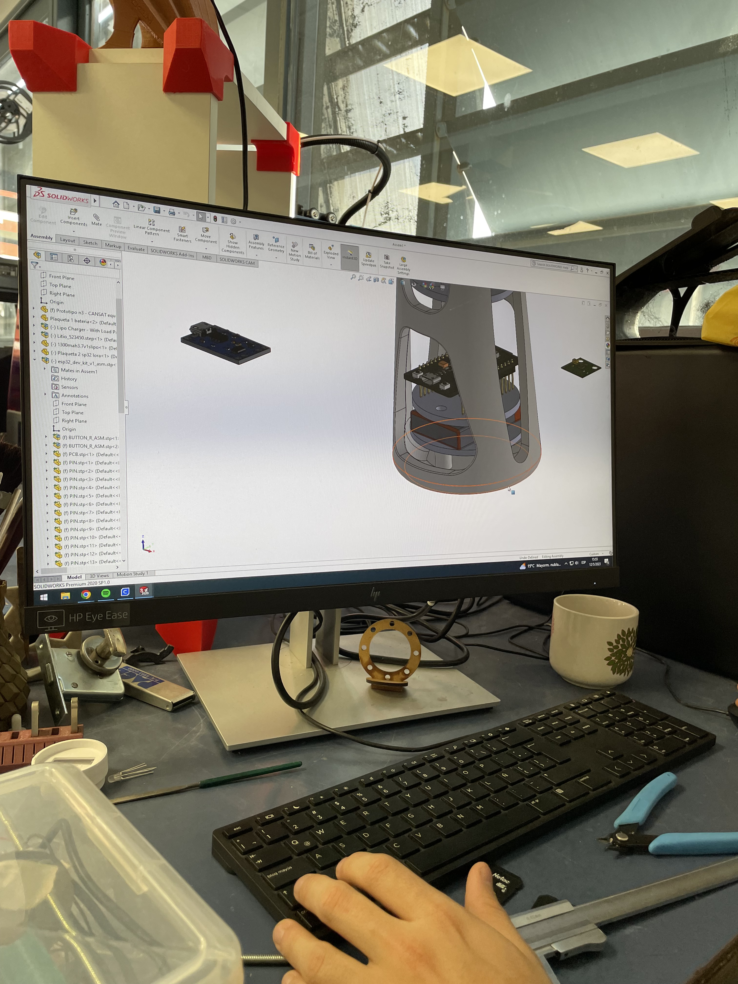
Multimedia/PROCESS/V2 making.jpg
