Miapaysse/CANSAT-UltraViolet/Multimedia/PROCESS/V1 first testing results.jpg

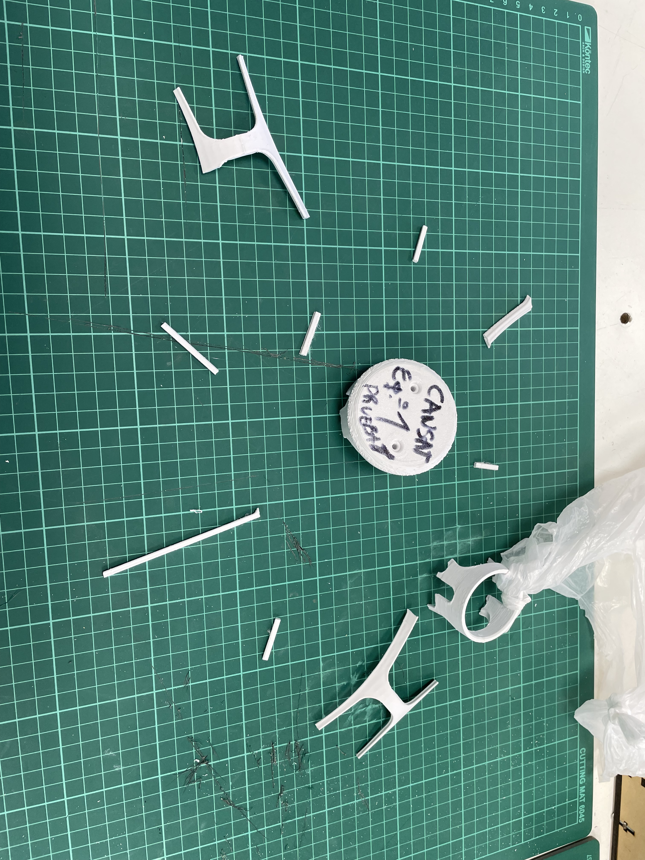
Multimedia/PROCESS/V1 first testing results.jpg
